bistromath/keezerhat/keezer.kicad_pcb

## KiCad design keezer.kicad_pcb (2018-01-05)

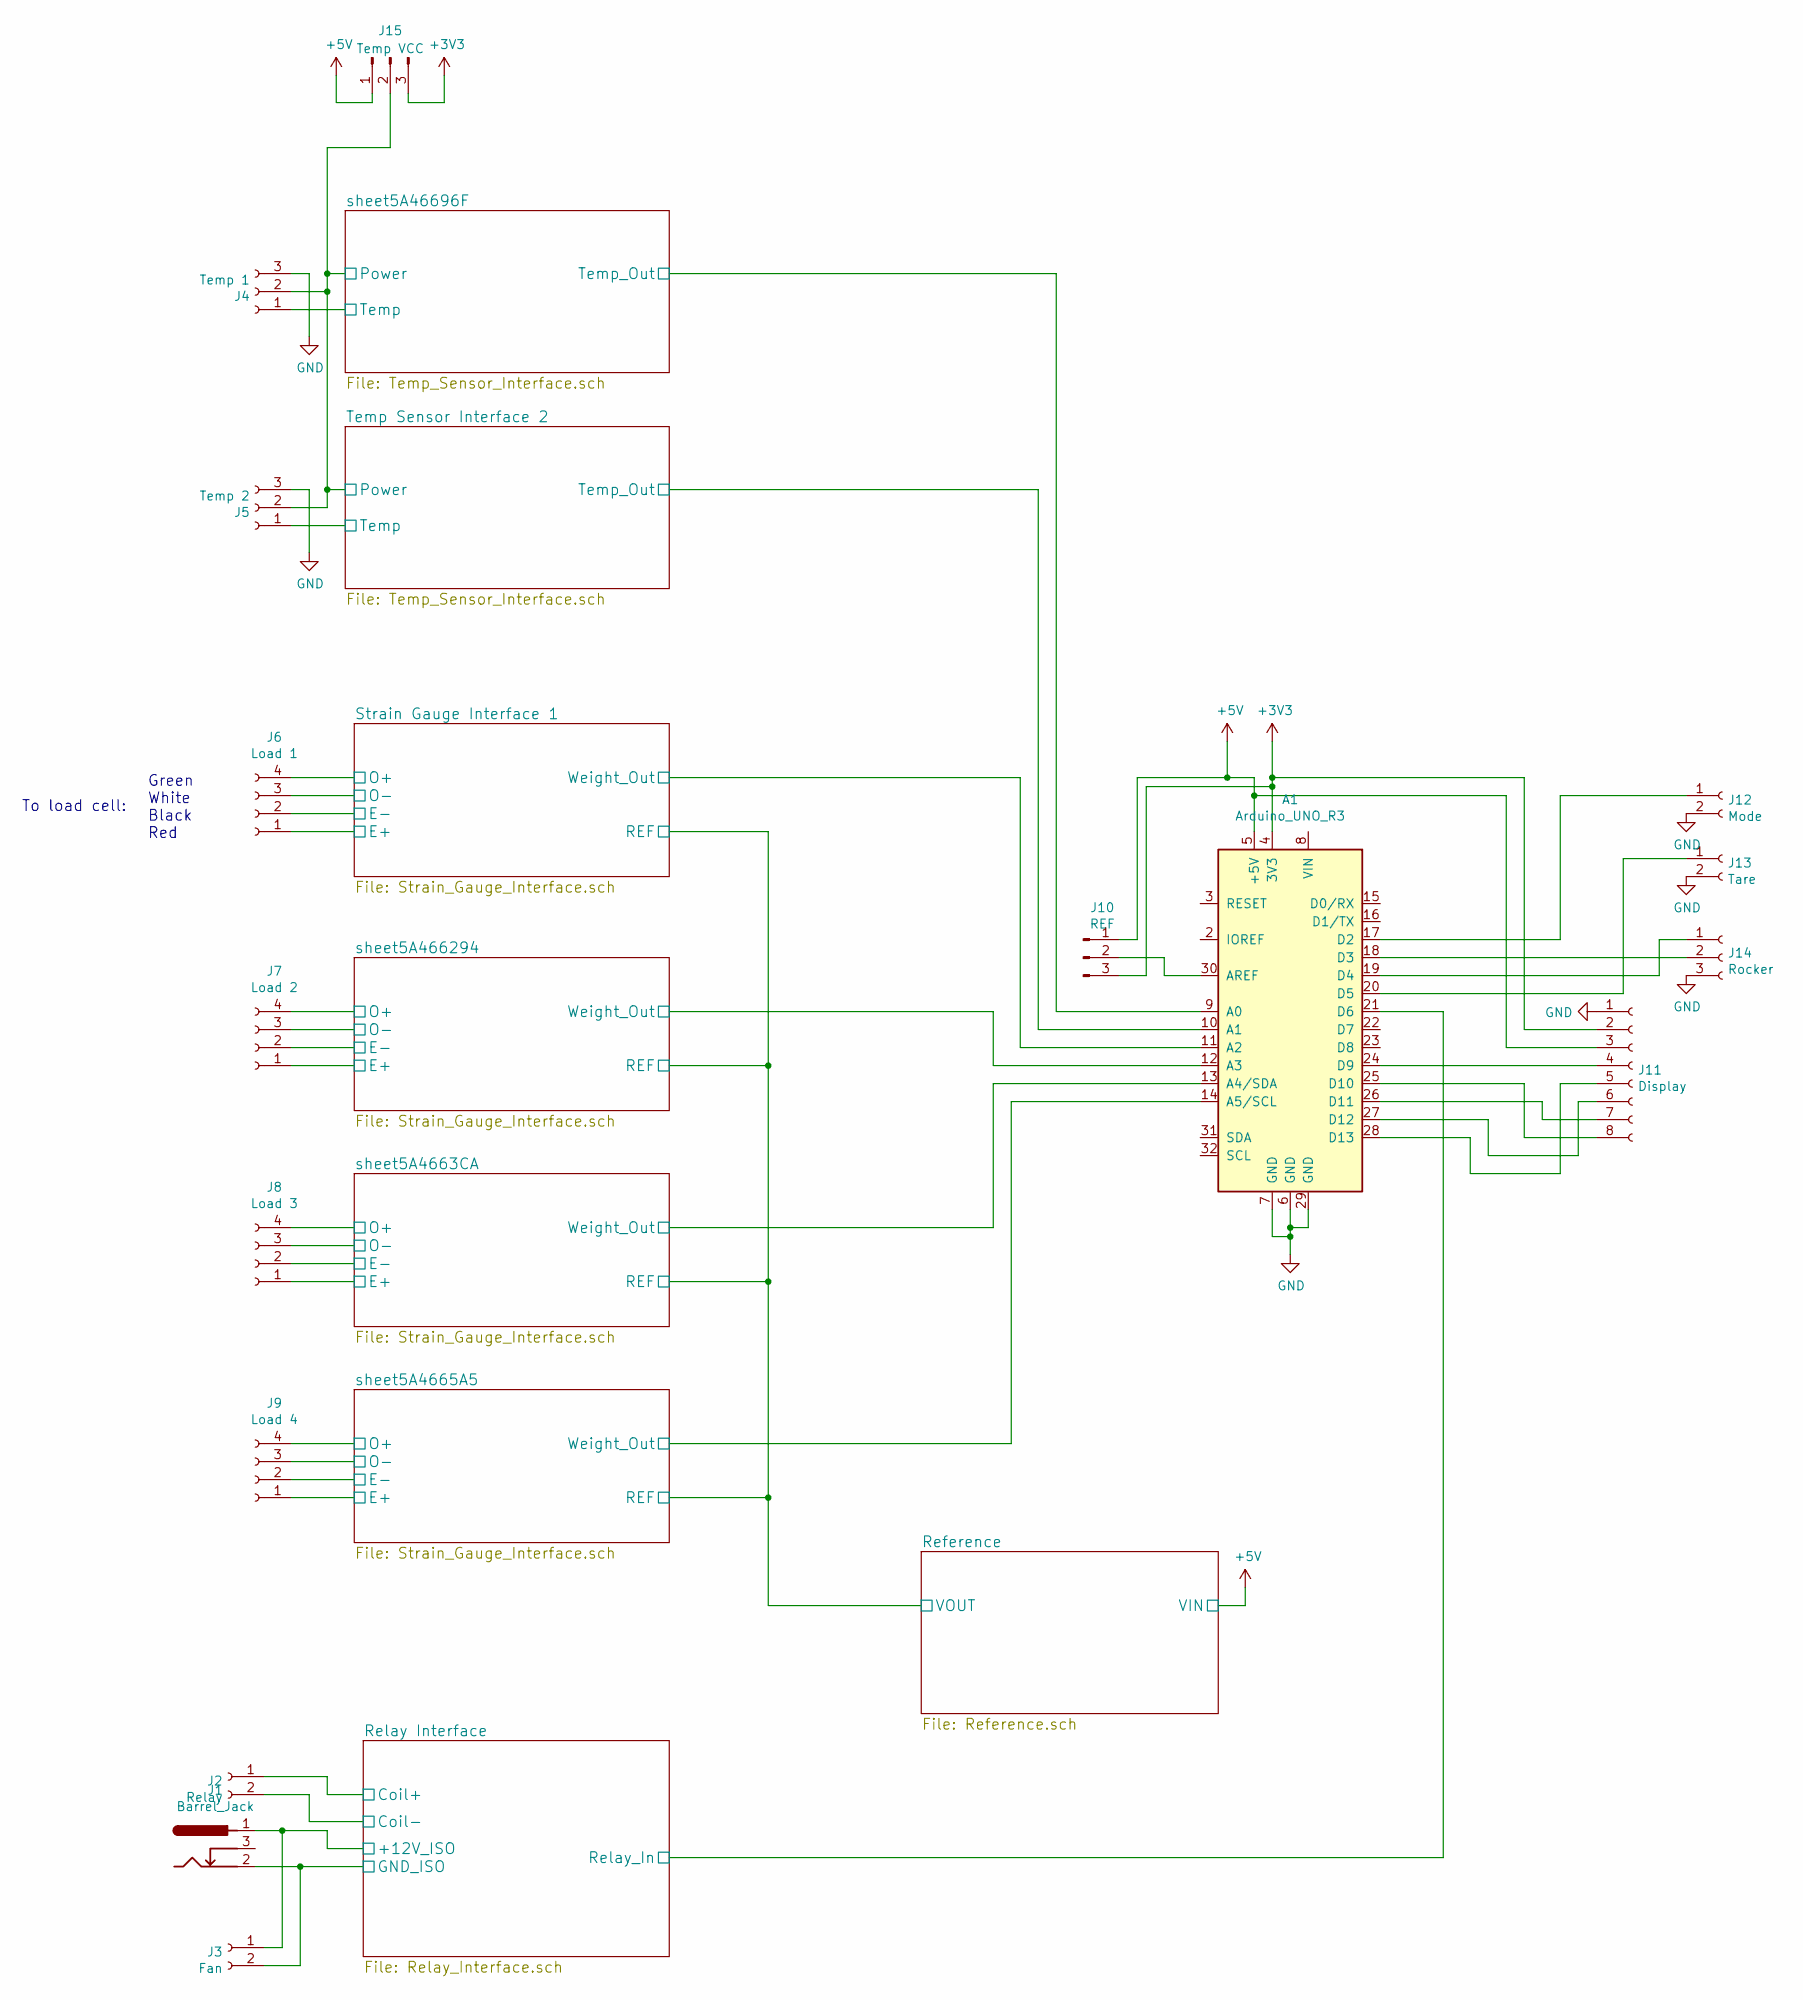
[picture p1: schematic keezer.sch]

Parts:
A1: Arduino_UNO_R3
J1: Barrel_Jack; Barrel_Jack_CUI_PJ-102AH
J2: Relay; Molex_NanoFit_1x02x2.50mm_Straight
J3: Fan; Molex_NanoFit_1x02x2.50mm_Straight
J4: Temp 1; Molex_NanoFit_1x03x2.50mm_Straight
J5: Temp 2; Molex_NanoFit_1x03x2.50mm_Straight
J6: Load 1; Molex_NanoFit_2x02x2.50mm_Straight
J7: Load 2; Molex_NanoFit_2x02x2.50mm_Straight
J8: Load 3; Molex_NanoFit_2x02x2.50mm_Straight
J9: Load 4; Molex_NanoFit_2x02x2.50mm_Straight
J10: REF; Pin_Header_Straight_1x03_Pitch2.54mm
J11: Display; Molex_NanoFit_2x04x2.50mm_Straight
J12: Mode; Molex_NanoFit_1x02x2.50mm_Straight
J13: Tare; Molex_NanoFit_1x02x2.50mm_Straight
J14: Rocker; Molex_NanoFit_1x03x2.50mm_Straight
J15: Temp VCC; Pin_Header_Straight_1x03_Pitch2.54mm

Connections:
+3V3: A1.4 (3V3), J10.3, J11.2, J15.3
+5V: A1.5 (+5V), J6.1, J7.1, J8.1, J9.1, J10.1, J11.3, J15.1; also elsewhere on the board
/Relay Interface/+12V_ISO: J1.1, J3.1; also elsewhere on the board
/Relay Interface/Coil+: J2.1; also elsewhere on the board
/Relay Interface/Coil-: J1.2, J2.2, J3.2; also elsewhere on the board
/Relay Interface/Relay_In: A1.21 (D6); also elsewhere on the board
/Strain Gauge Interface 1/O+: J6.4; also elsewhere on the board
/Strain Gauge Interface 1/O-: J6.3; also elsewhere on the board
/Strain Gauge Interface 1/Weight_Out: A1.11 (A2); also elsewhere on the board
/Temp Sensor Interface 2/Power: J4.2, J5.2, J15.2; also elsewhere on the board
/Temp Sensor Interface 2/Temp: J5.1; also elsewhere on the board
/Temp Sensor Interface 2/Temp_Out: A1.10 (A1); also elsewhere on the board
/sheet5A4663CA/O+: J8.4; also elsewhere on the board
/sheet5A4663CA/O-: J8.3; also elsewhere on the board
/sheet5A4663CA/Weight_Out: A1.13 (A4/SDA); also elsewhere on the board
/sheet5A4665A5/O+: J9.4; also elsewhere on the board
/sheet5A4665A5/O-: J9.3; also elsewhere on the board
/sheet5A4665A5/Weight_Out: A1.14 (A5/SCL); also elsewhere on the board
/sheet5A46696F/Temp: J4.1; also elsewhere on the board
/sheet5A46696F/Temp_Out: A1.9 (A0); also elsewhere on the board
/sheet5A466294/O+: J7.4; also elsewhere on the board
/sheet5A466294/O-: J7.3; also elsewhere on the board
/sheet5A466294/Weight_Out: A1.12 (A3); also elsewhere on the board
GND: A1.6 (GND), A1.7 (GND), A1.29 (GND), J4.3, J5.3, J6.2, J7.2, J8.2, J9.2, J11.1, J12.2, J13.2, J14.3; also elsewhere on the board
unnamed: A1.17 (D2), J12.1
unnamed: A1.18 (D3), J14.2
unnamed: A1.19 (D4), J14.1
unnamed: A1.20 (D5), J13.1
unnamed: A1.24 (D9), J11.4
unnamed: A1.25 (D10), J11.8
unnamed: A1.26 (D11), J11.7
unnamed: A1.27 (D12), J11.6
unnamed: A1.28 (D13), J11.5
unnamed: A1.30 (AREF), J10.2

Notes on the sheet:
Green White Black Red
To load cell:

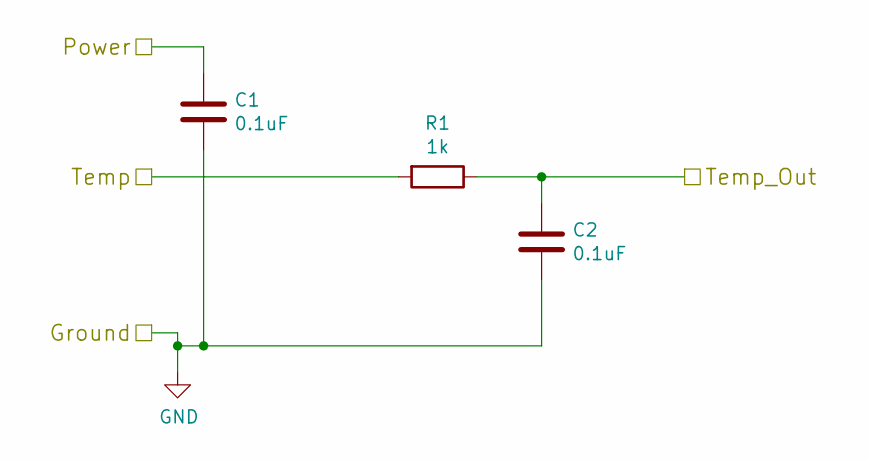
[picture p2: schematic Temp_Sensor_Interface.sch]

Parts:
C1, C2: 0.1uF; C_0805_HandSoldering
R1: 1k; R_0805_HandSoldering

Connections:
/Temp Sensor Interface 2/Power: C1.1; also elsewhere on the board
/Temp Sensor Interface 2/Temp: R1.2; also elsewhere on the board
/Temp Sensor Interface 2/Temp_Out: C2.1, R1.1; also elsewhere on the board
GND: C1.2, C2.2; also elsewhere on the board

Parts of its further copies:
C3, C4: 0.1uF; C_0805_HandSoldering
R4: 1k; R_0805_HandSoldering

Connections of its further copies:
/Temp Sensor Interface 2/Power: C3.1; also elsewhere on the board
/sheet5A46696F/Temp: R4.2; also elsewhere on the board
/sheet5A46696F/Temp_Out: C4.1, R4.1; also elsewhere on the board
GND: C3.2, C4.2; also elsewhere on the board

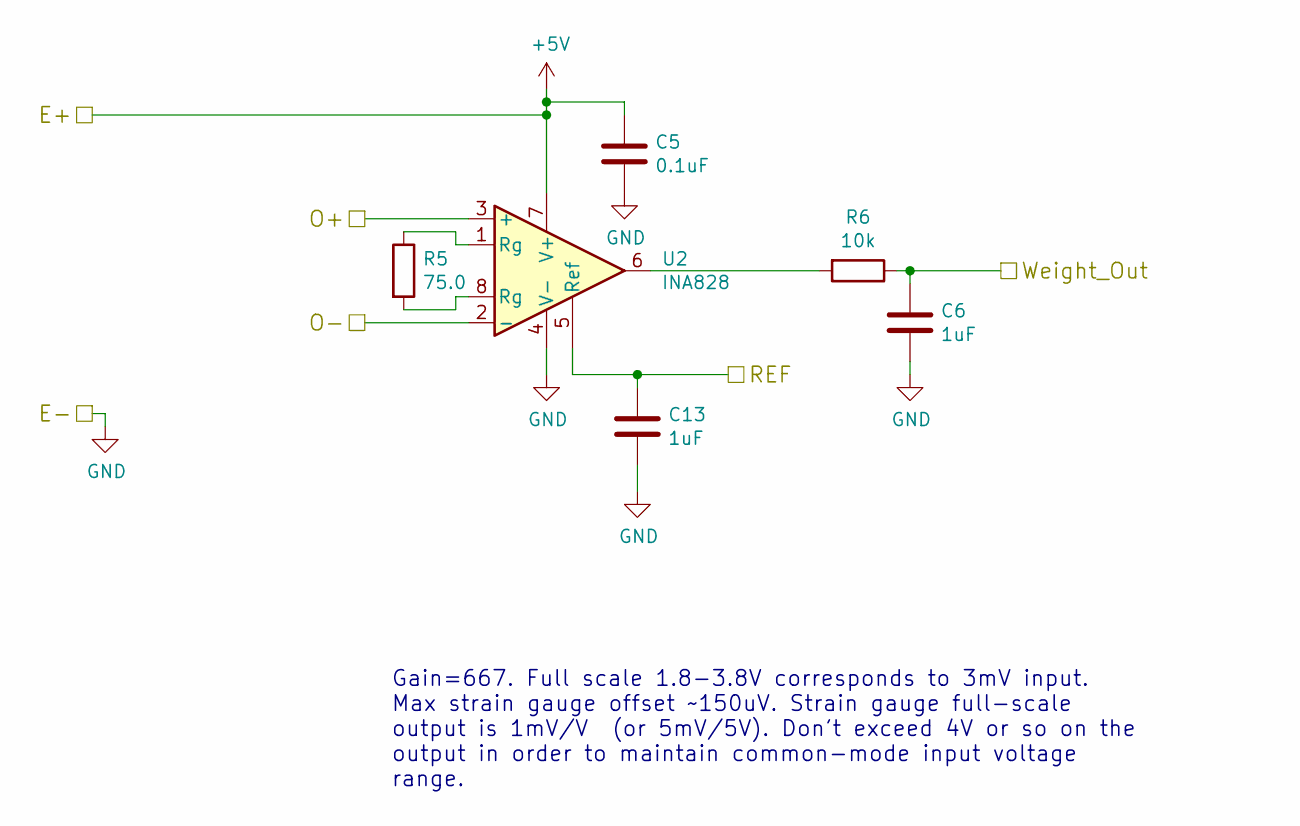
[picture p3: schematic Strain_Gauge_Interface.sch]

Parts:
C5: 0.1uF; C_0805_HandSoldering
C6, C16: 1uF; C_0805_HandSoldering
R5: 75.0; R_0805_HandSoldering
R6: 10k; R_0805_HandSoldering
U2: INA828; SOIC-8_3.9x4.9mm_Pitch1.27mm

Connections:
+5V: C5.1, U2.7 (V+); also elsewhere on the board
/Strain Gauge Interface 1/O+: U2.3 (+); also elsewhere on the board
/Strain Gauge Interface 1/O-: U2.2 (-); also elsewhere on the board
/Strain Gauge Interface 1/REF: C16.1, U2.5 (Ref); also elsewhere on the board
/Strain Gauge Interface 1/Weight_Out: C6.1, R6.1; also elsewhere on the board
GND: C5.2, C6.2, C16.2, U2.4 (V-); also elsewhere on the board
unnamed: R5.1, U2.1 (Rg)
unnamed: R5.2, U2.8 (Rg)
unnamed: R6.2, U2.6

Parts of its further copies:
C7, C9, C11: 0.1uF; C_0805_HandSoldering
C8, C10, C12, C13, C14, C15: 1uF; C_0805_HandSoldering
R7, R9, R11: 75.0; R_0805_HandSoldering
R8, R10, R12: 10k; R_0805_HandSoldering
U3, U4, U5: INA828; SOIC-8_3.9x4.9mm_Pitch1.27mm

Connections of its further copies:
+5V: C7.1, C9.1, C11.1, U3.7 (V+), U4.7 (V+), U5.7 (V+); also elsewhere on the board
/Strain Gauge Interface 1/REF: C13.1, C14.1, C15.1, U3.5 (Ref), U4.5 (Ref), U5.5 (Ref); also elsewhere on the board
/sheet5A4663CA/O+: U4.3 (+); also elsewhere on the board
/sheet5A4663CA/O-: U4.2 (-); also elsewhere on the board
/sheet5A4663CA/Weight_Out: C10.1, R10.1; also elsewhere on the board
/sheet5A4665A5/O+: U5.3 (+); also elsewhere on the board
/sheet5A4665A5/O-: U5.2 (-); also elsewhere on the board
/sheet5A4665A5/Weight_Out: C12.1, R12.1; also elsewhere on the board
/sheet5A466294/O+: U3.3 (+); also elsewhere on the board
/sheet5A466294/O-: U3.2 (-); also elsewhere on the board
/sheet5A466294/Weight_Out: C8.1, R8.1; also elsewhere on the board
GND: C7.2, C8.2, C9.2, C10.2, C11.2, C12.2, C13.2, C14.2, C15.2, U3.4 (V-), U4.4 (V-), U5.4 (V-); also elsewhere on the board
unnamed: R7.1, U3.1 (Rg)
unnamed: R7.2, U3.8 (Rg)
unnamed: R8.2, U3.6
unnamed: R9.1, U4.1 (Rg)
unnamed: R9.2, U4.8 (Rg)
unnamed: R10.2, U4.6
unnamed: R11.1, U5.1 (Rg)
unnamed: R11.2, U5.8 (Rg)
unnamed: R12.2, U5.6

Notes on the sheet:
Gain=667. Full scale 1.8-3.8V corresponds to 3mV input. Max strain gauge offset ~~150uV. Strain gauge full-scale output is 1mV/V (or 5mV/5V). Don't exceed 4V or so on the output in order to maintain common-mode input voltage range.

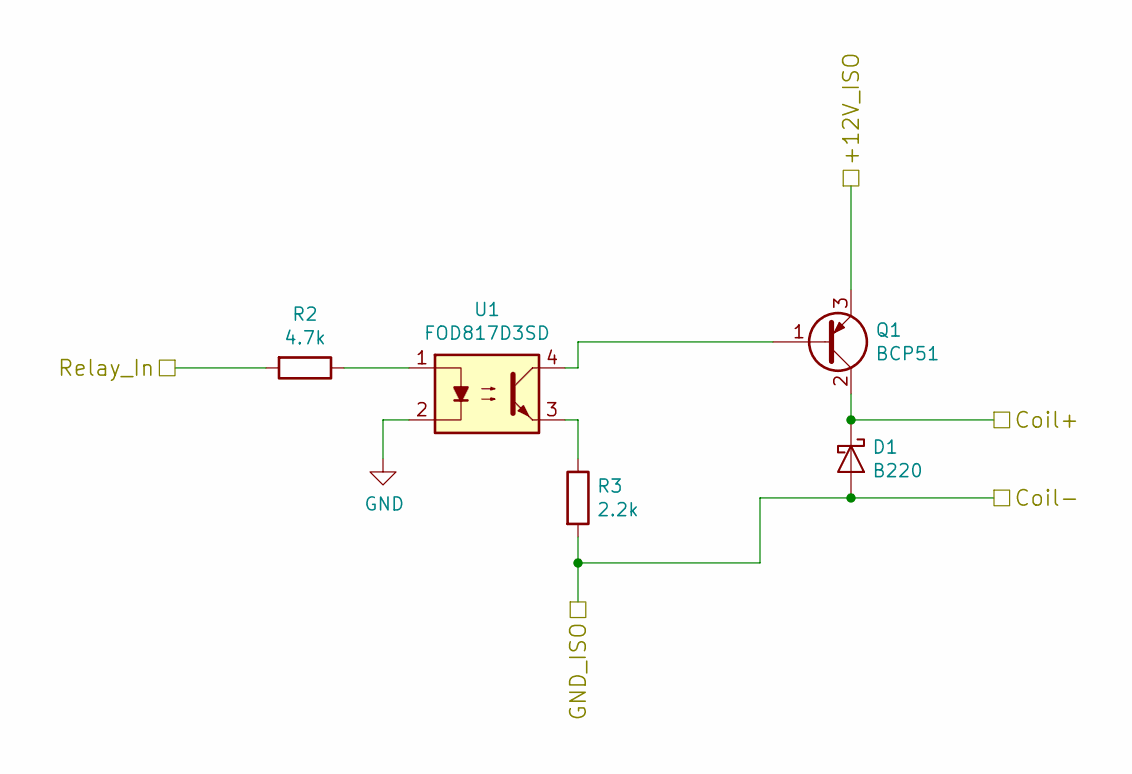
[picture p4: schematic Relay_Interface.sch]

Parts:
D1: B220; D_SMB_Handsoldering
Q1: BCP51; SOT-223-3_TabPin2
R2: 4.7k; R_0805_HandSoldering
R3: 2.2k; R_0805_HandSoldering
U1: FOD817D3SD; SO-4_4.4x3.6mm_Pitch2.54mm

Connections:
/Relay Interface/+12V_ISO: Q1.3 (E); also elsewhere on the board
/Relay Interface/Coil+: D1.1 (K), Q1.2 (C); also elsewhere on the board
/Relay Interface/Coil-: D1.2 (A), R3.2; also elsewhere on the board
/Relay Interface/Relay_In: R2.2; also elsewhere on the board
GND: U1.2; also elsewhere on the board
unnamed: Q1.1 (B), U1.4
unnamed: R2.1, U1.1
unnamed: R3.1, U1.3

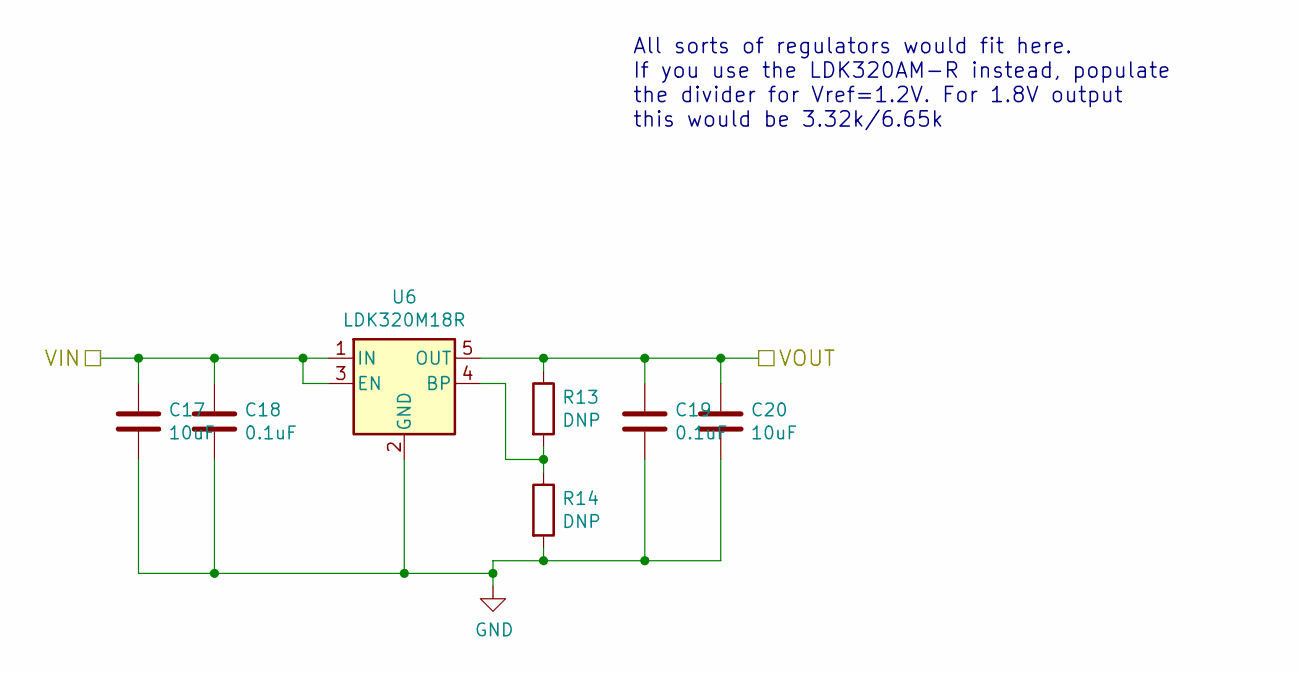
[picture p5: schematic Reference.sch]

Parts:
C17, C20: 10uF; C_0805_HandSoldering
C18, C19: 0.1uF; C_0805_HandSoldering
R13, R14: DNP; R_0805_HandSoldering
U6: LDK320M18R; SOT-23-5_HandSoldering

Connections:
+5V: C17.1, C18.1, U6.1 (IN), U6.3 (EN); also elsewhere on the board
/Strain Gauge Interface 1/REF: C19.1, C20.1, R13.1, U6.5 (OUT); also elsewhere on the board
GND: C17.2, C18.2, C19.2, C20.2, R14.2, U6.2 (GND); also elsewhere on the board
unnamed: R13.2, R14.1, U6.4 (BP)

Notes on the sheet:
All sorts of regulators would fit here. If you use the LDK320AM-R instead, populate the divider for Vref=1.2V. For 1.8V output this would be 3.32k/6.65k

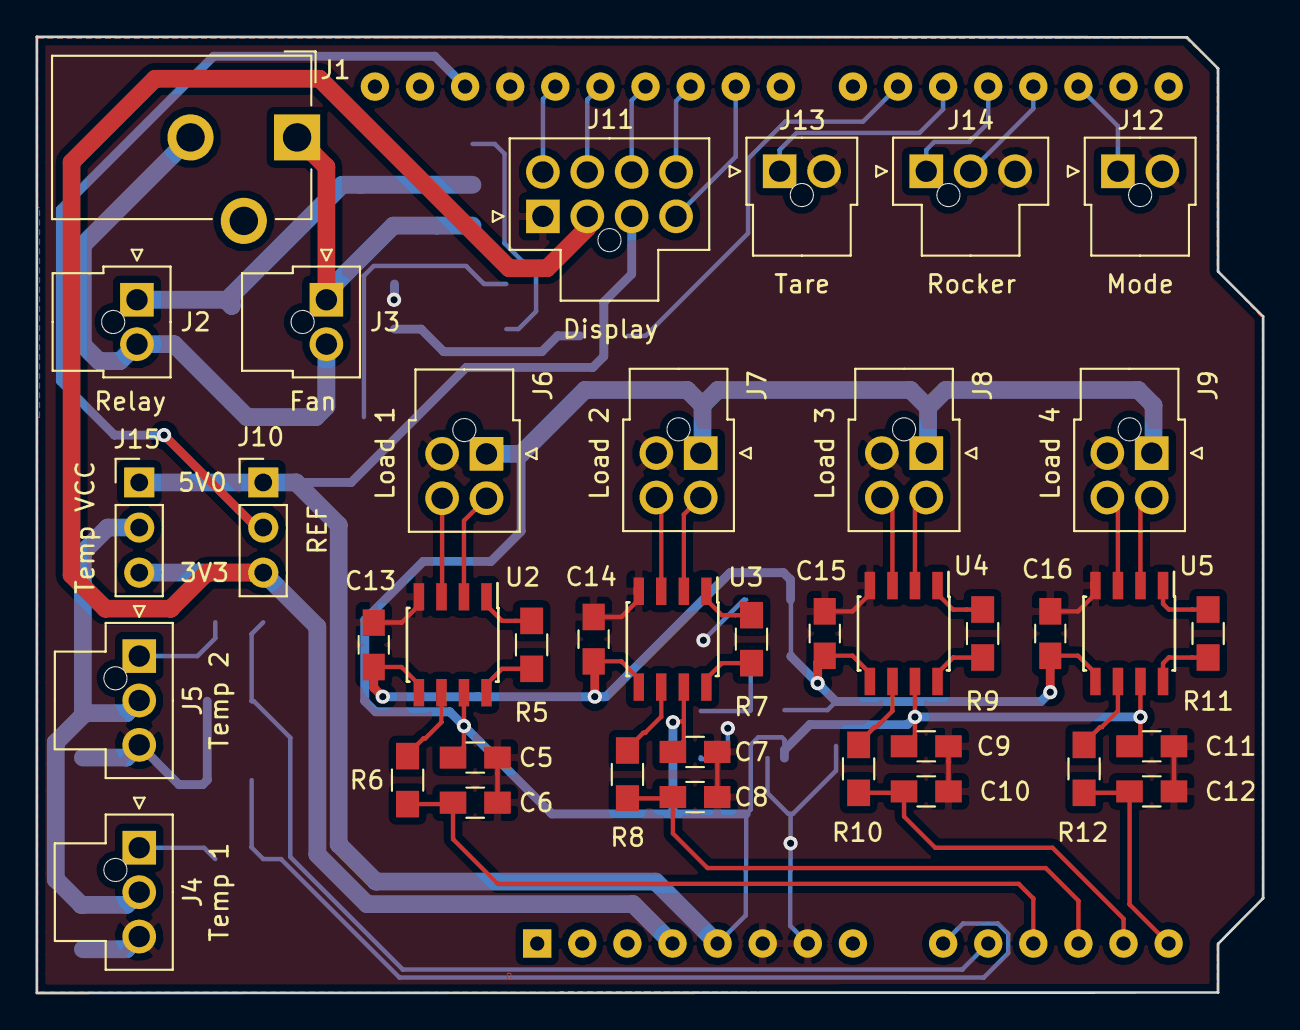
[picture p6: board keezer.kicad_pcb from above]

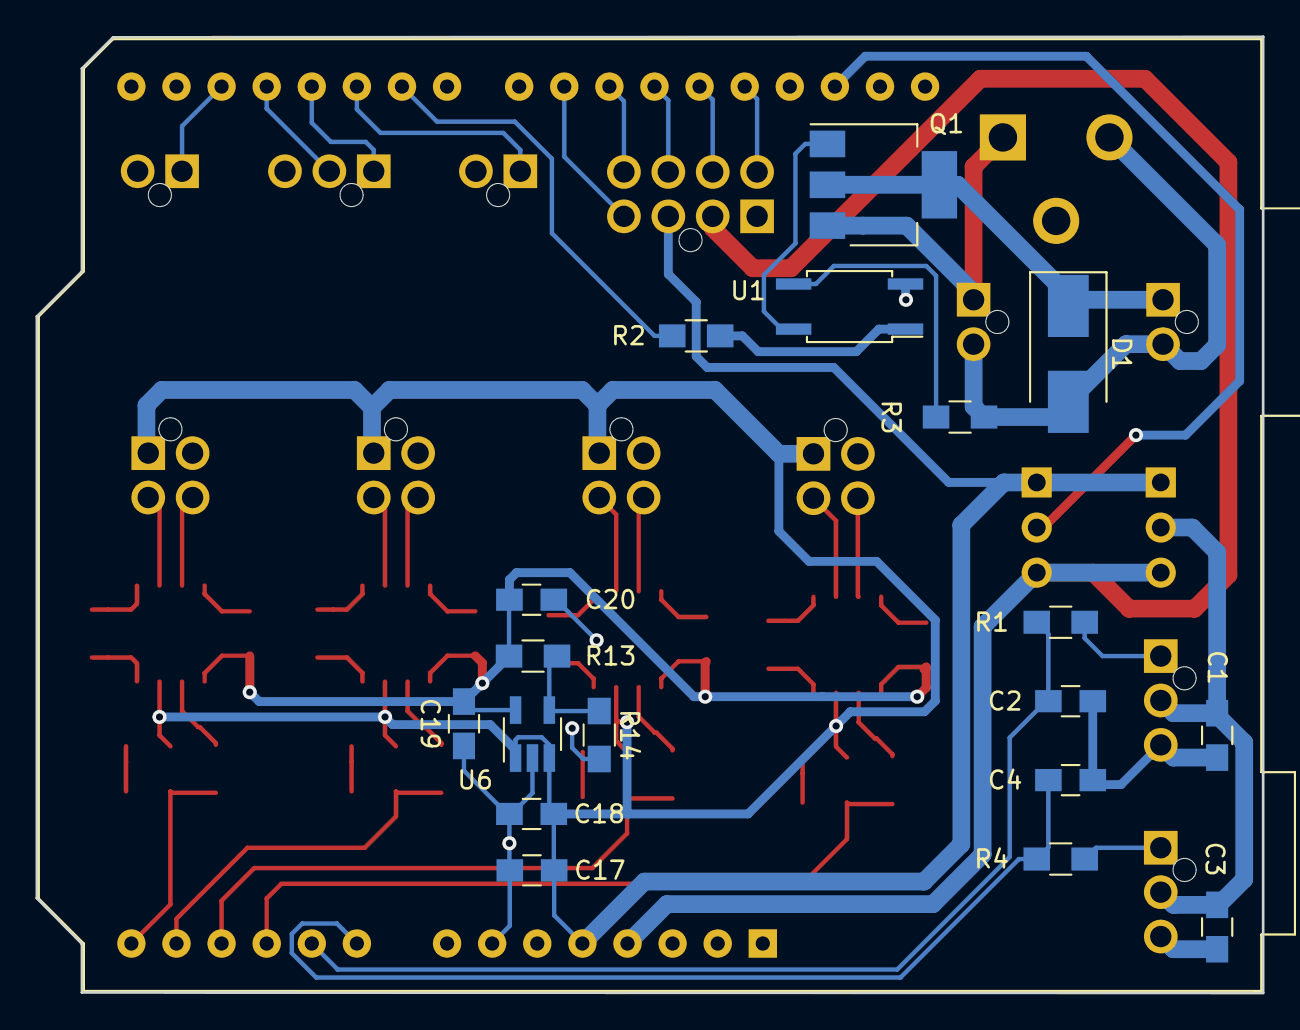
[picture p7: board keezer.kicad_pcb from below]

Board: 2 copper layers, 69.1 x 53.8 mm, 58 parts (19 on the bottom side), 51 nets.
