bistromath/keezerhat/(commit log)

2017-12-30 Initial commit.
    [Reference.sch, Relay_Interface.sch, Strain_Gauge_Interface.sch, Temp_Sensor_Interface.sch, keezer.kicad_pcb, keezer.sch]
2017-12-31 Pretty much ready to go. Should verify barrel jack first. Needs a logo.
    [Reference.sch, Relay_Interface.sch, Strain_Gauge_Interface.sch, Temp_Sensor_Interface.sch, keezer.kicad_pcb, keezer.sch]
2018-01-01 Cosmetic changes mostly.
    [keezer.kicad_pcb]
2018-01-05 Logo. Finally.
    [keezer.kicad_pcb]
